tandat-EES-ICDM/EE3427_CC01_252_Group06_Embedded-System/README.md

[Demo Video]:  
https://drive.google.com/file/d/16Uh21a4lqSv_YghYvDpnQTZxxrZzBnIu/view?usp=drive_link  
[Demo Video - Revised: Add 2 more non-volatile alarms -> total 3 alarms]:  
https://drive.google.com/file/d/1G-kM-oG9oD7Pn4vBYBXZ9WEiFOjN3P8L/view?usp=sharing
