tandat-EES-ICDM/EE3427_CC01_252_Group06_Embedded-System/01_DESIGN/Requirements.xlsx

Sheet: Functional_Requirements
ID | Requirement
FR-1 | Time display mode
FR-1.1 | The system shall display time information on a 16×2 LCD in the “time display” screen. In time display mode, the screen shall update at least once per second.
FR-1.2 | The first LCD row shall show HH:MM:SS in 24-hour format (00–23).
FR-1.2.a | The first row shall show a bell icon when the alarm status is Activated (Mode 1) and show no bell when alarm status is Deactivated (Mode 0)
FR-1.2.b | The first row shall show a thermometer icon and show temperature value read from the DS3231 internal temperature sensor (integer, no fractional part) followed by “°C”.
FR-1.3 | The system shall display day-of-week and date on LCD row 2.
FR-1.3.a | Day-of-week shall be shown as a 3-letter abbreviation (Mon…Sun).
FR-1.3.b | Date format shall be DD/MM/YYYY.
FR-2 | Power-up screen
FR-2.1 | On power-up, the system shall show a splash screen: Row 1 “Real Time Clock”, Row 2 “With Alarm”, for 2 seconds, then clear and enter time display mode.
FR-3 | Set Time mode (7-step editing)
FR-3.1 | From time display mode, the system shall enter Set Time mode when SET TIME button is pressed and allow editing of 7 fields in sequence: hour → minute → second → day-of-week → date → month → year by pressing "SET TIME" button | Digtal Clock with LCD Display
FR-3.1.a | The currently edited field shall blink to indicate what is being edited.
FR-3.1.b | Hour shall wrap 23→00 and 00→23.
FR-3.1.c | Minute and second shall wrap 59→00 and 00→59.
FR-3.1.d | Day-of-week shall increment/decrement and wrap 7→0 and 0→7. |  | s
FR-3.1.e | Date shall wrap 31→0 and 0→31.
FR-3.1.f | Month shall wrap 12→0 and 0→12.
FR-3.1.g | Year shall increment and wrap 2030→2000; decrement and wrap below 0→2030.
FR-3.2 | When completing Set Time, the system shall write the new values to the RTC and display a finish message: Row 1 “Set Date Finish” and Row 2 “Set Time Finish”, then return to time display mode.
FR-4 | Early commit behavior for Set Time
FR-4.1 | While setting time, the system shall allow early commit without stepping through all 7 fields by pressing SET ALARM (commit immediately and show finish messages).
FR-5 | Set Alarm mode (5-step editing)
FR-5.1 | From time display mode, pressing SET ALARM button shall enter Set Alarm mode and allow editing in 5 steps : status (Activated or Deactivated) → hour → minute → second → save by pressing "SET ALARM" button.
FR-5.1.a | Step 1 shall blink the status field; UP selects “Activated ” and DOWN selects “Deactivate” (displayed as “Alarm Activated ” / “Alarm Deactivate”).
FR-5.1.b | Steps 2–4 adjust alarm hour/min/sec (00–23 / 00–59 / 00–59) with saturation at limits (no wrap).
FR-5.1.c | Step 5 shall display “Set Alarm Finish” and “-EEPROM Updated-”, then return to time display mode.
FR-6 | Early commit behavior for Set Alarm
FR-6.1 | While setting alarm, the system shall allow early commit without stepping through all 5 steps by pressing SET TIME (commit immediately and show finish messages “Set Alarm Finish” and “-EEPROM Updated-”).
FR-7 | Alarm persistence in EEPROM
FR-7.1 | The system shall store alarm hour/min/sec and activation status in MCU internal EEPROM and restore them at boot.
FR-7.1.a | EEPROM update shall occur at the end of Set Alarm (“-EEPROM Updated-”).
FR-7.1.b | Alarm settings shall persist across power loss.
FR-7.1.c | EEPROM writes shall occur only when saving alarm settings.
FR-8 | Alarm trigger and buzzer output
FR-8.1 | When alarm is activated, the system shall drive the buzzer when current time matches alarm time.
FR-8.1.a | The buzzer shall be driven by a 0/5 V digital output (active-high) on the buzzer pin.
FR-8.1.b | When triggered, the system shall generate an audible beep by driving buzzer HIGH for 300 ms then LOW
FR-9 | Button press and press-and-hold behavior
FR-9.1 | UP and DOWN buttons shall support both single-step increments and press-and-hold for faster adjustment (hold repeats while button remains pressed).

Sheet: NonFunctional_Requirements
ID | Requirement
NFR-1 | Firmware/Hardware implementation constraints
NFR-1.1 | Firmware shall be implemented in register-level C/C++ using AVR-GCC in Microchip Studio and shall not use Arduino core/libraries (Wire.h, LiquidCrystal.h, etc.).
NFR-1.1.a | All I2C and LCD access shall be implemented via direct AVR registers.
NFR-1.1.b | The firmware shall implement explicit state machines for Set Time (7 steps) and Set Alarm (5 steps).
NFR-1.1.c | Firmware shall avoid polling and use timer interrupts to reduce power.
NFR-1.1.d | Arduino code & Arduino core may be used only to verify functional behavior, not as part of the final firmware & hardware.
NFR-2 | Responsiveness
NFR-2.1 | Button response time (press to UI action) shall be < 50 ms.
NFR-2.1.a | Debounce Filter shall be ≤ 30 ms.
NFR-2.1.b | Hold detection shall start within 500 ms of continuous press.
NFR-3 | Time accuracy
NFR-3.1 | The displayed time shall have error < 1 s/day (driven by DS3231 accuracy).
NFR-3.1.a | System shall read time from RTC at least once per second. | Digtal Clock with LCD Display
NFR-3.1.b | MCU clock tolerance shall not affect timekeeping (RTC is time base).
NFR-3.1.c | Alarm trigger shall reference module RTC.
NFR-4 | Power source and operating rails
NFR-4.1 | The system shall operate from a 9V DC input supplied by either a 9V battery or a 9V adapter.
NFR-4.1.a | The acceptable input voltage range shall be 8–12 V DC.
NFR-4.1.b | The system shall generate a regulated 5V rail for ATmega168PA and peripherals (DS3231, 16×2 LCD, buzzer driver).
NFR-4.1.c | When powered by a 9V battery, the system shall operate continuously for ≥ X hours under typical load (X based on measured test).
NFR-4.1.d | Battery capacity shall be selected such that ≥ 30% margin remains after the required runtime.
NFR-5 | Power regulation choice
NFR-5.1 | The design shall specify whether a buck or linear regulator is used for converting 9V input to 5V and shall provide efficiency-based power calculations.
NFR-5.1.a | If powered by a 9V battery, a buck regulator shall be used unless justified otherwise.
NFR-5.1.b | If powered by a 9V adapter, a linear regulator may be used only if thermal dissipation is within safe limits; otherwise a buck regulator shall be used.
NFR-5.1.c | The 5V regulator shall support ≥ 200 mA peak load to cover buzzer + LCD/backlight transients.
NFR-5.1.d | LCD backlight current shall be limited to ≤ 20 mA continuous (fixed ON, no PWM).
NFR-6 | PCB/layout constraints (If possible)
NFR-6.1 | PCB shall follow layout constraints.
NFR-6.1.a | Power traces shall be ≥ 20–30 mil width.
NFR-6.1.b | Crystal and decoupling capacitors shall be placed close to MCU pins.
NFR-6.1.c | A copper ground plane shall be used for noise reduction.
NFR-6.1.d | Board outline shall not exceed 140 mm × 100 mm.
