tandat-EES-ICDM/EE3427_CC01_252_Group06_Embedded-System/05_BOM/BOM_v2.xlsx

Bill of Materials (BOM)
1. Main control unit
No. | Component | Model / Specification | Qty | Selection Rationale
1 | Microcontroller | STM32F103C8T6 | 1 | 64KB Flash I2C used for RTC module Enough pins for LCD, buttons, buzzer
2 | Crystal Oscillator | 8MHz | 1 | Stable clock source for precise timing and I2C
3 | Capacitor | 22pF Ceramic | 2 | Crystal load capacitors
4 | Resistor | 10kΩ 1/4W | 1 | RESET pull-up
5 | Capacitor | 100nF Ceramic | 5 | MCU decoupling (VCC/AVCC)
2. Real-time Clock (RTC) block
No. | Component | Model / Specification | Qty | Selection Rationale
6 | RTC Module | DS3231 (ZS-042 type) | 1 | <1s/day accuracy, integrated temperature sensor
7 | Backup Battery | CR2032 | 1 | Maintains time during power loss
8 | Resistor | 4.7kΩ | 2 | I2C pull-up resistors (if not included on module)
3. LCD Display block
No. | Component | Model / Specification | Qty | Selection Rationale
9 | LCD Module | LCD1602 / LM016L | 1 | HD44780 compatible, 5V operation, supports custom characters
10 | Trimpot | 10kΩ | 1 | LCD contrast adjustment
11 | Resistor | ~56Ω | 1 | Backlight current limiting (if not integrated)
12 | Transistor | S8050 / 2N2222 | 1 | Buzzer driver
13 | Resistor | 1kΩ | 1 | Base resistor for transistor
4. Alarm output block
No. | Component | Model / Specification | Qty | Selection Rationale
14 | Buzzer | Active 5V Buzzer | 1 | No need for tone generation (simplifies firmware)
15 | Transistor | 2N2222 / S8050 | 1 | Protects MCU from high current
16 | Resistor | 1kΩ | 1 | Base resistor for buzzer driver
5. User input block
No. | Component | Model / Specification | Qty | Selection Rationale
17 | Tactile Switch | 6x6mm Push Button | 4 | SET TIME, UP, DOWN, SET ALARM
18 | Resistor | 10kΩ | 4 | External pull-up
6. Power supply block
No. | Component | Model / Specification | Qty | Selection Rationale
18 | Buck Regulator IC | LM2596S-5 | 1 | ~85% efficiency, suitable for battery operation
19 | Schottky Diode | SS34 (3A, 40V) | 1 | Freewheel diode for buck converter
20 | Inductor | 33µH ≥1A | 1 | Buck converter energy storage
21 | Electrolytic Capacitor | 220µF 25V | 1 | Input bulk capacitor
22 | Electrolytic Capacitor | 220µF 10V | 1 | Output bulk capacitor
23 | Ceramic Capacitor | 100nF | 2–3 | Regulator bypass capacitors
24 | Polyfuse (optional) | 500mA–1A | 1 | Overcurrent protection
25 | 9V Battery | 9V Input | 1 | External power connector
26 | LDO Regulator IC | AMS1117-3.3 | 1 | Converts 5V rail to 3.3V
7. Programming & Connectivity
No. | Component | Model / Specification | Qty | Selection Rationale
27 | STLink connector | STLink V2 | 1 | Load firmware
28 | LCD Header | 1x16 2.54mm | 1 | LCD connection
29 | RTC Header | 1x4 2.54mm | 1 | DS3231 connection
Summary by Category
 | Category | Description
 | Core ICs | MCU + RTC + Buck Regulator
 | Discrete Components | Resistors, capacitors, transistors
 | Modules | LCD1602, DS3231
 | User Interface | 4 push buttons
 | Protection | Schottky diode + optional polyfuse
Design Justification
 | Sufficient GPIO and memory resources
 | Sufficient Flask memory for alarm storage
 | DS3231 ensures <1s/day accuracy
 | Buck regulator satisfies 24-hour battery requirement
 | Not over-dimensioned (avoids unnecessary cost)
 | Easily available in Vietnam
 | Compatible with PCB size constraint (<14cm × 10cm)
