tandat-EES-ICDM/EE3427_CC01_252_Group06_Embedded-System/02_Schematic_pdf/Digital Clock with LCD Display.pdf

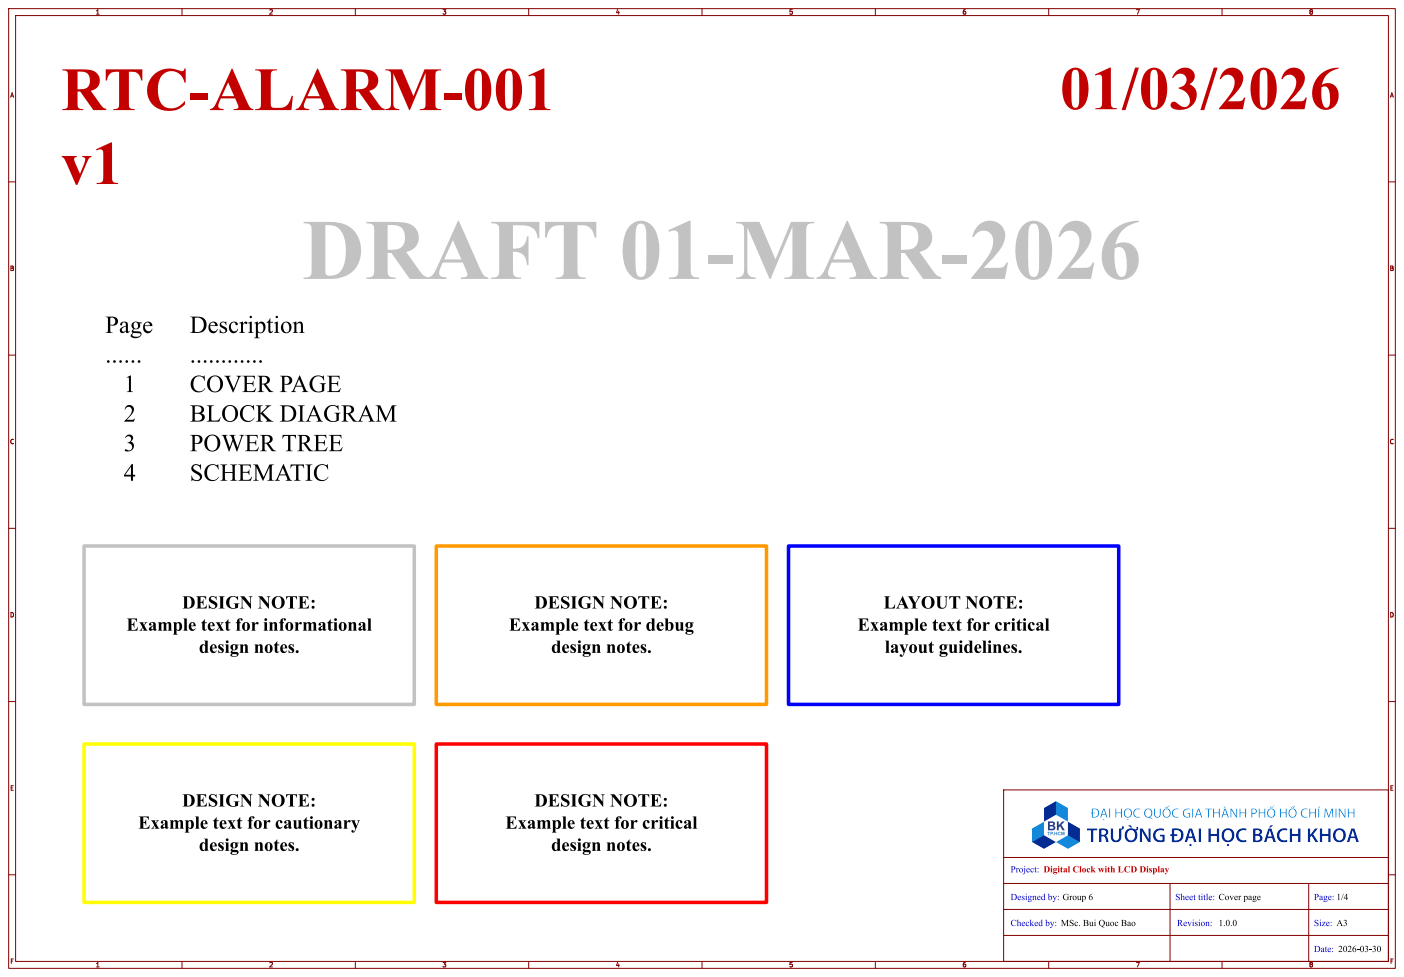
[picture p25: page 1]

File: untitled.kicad_sch main_schematic File: main_schematic.kicad_sch LAYOUT NOTE:

Designedby: Group6 | Sheettitle: Coverpage | Page:1/4 | F Project:

Checkedby: MSc.Bui QuocBao | Revision: 1.0.0 | Size: A3

Date: 2026-03-30

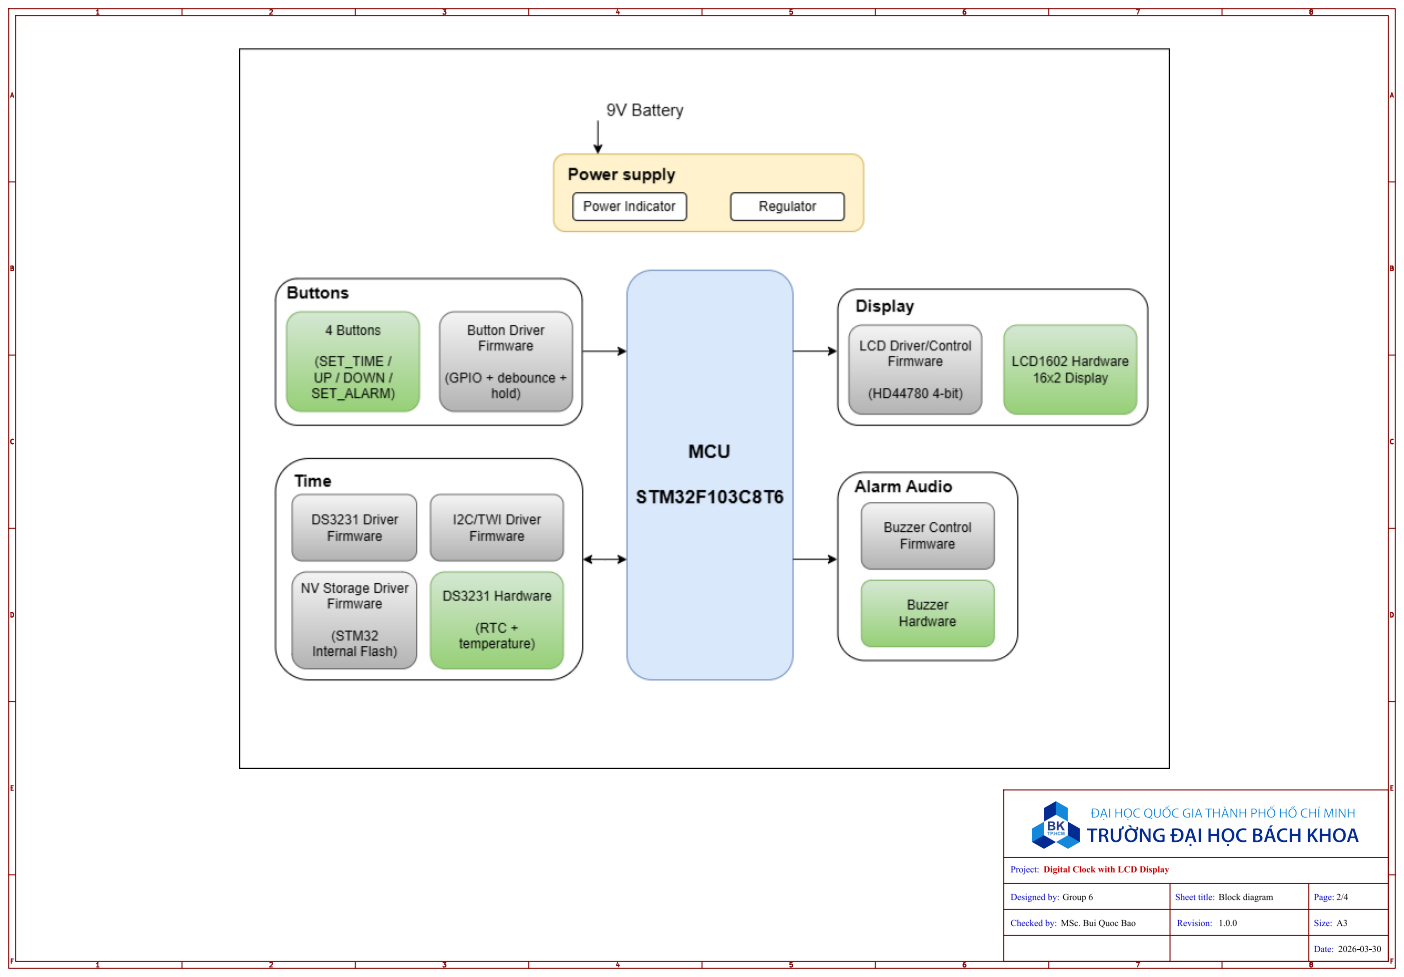
[picture p26: page 2]

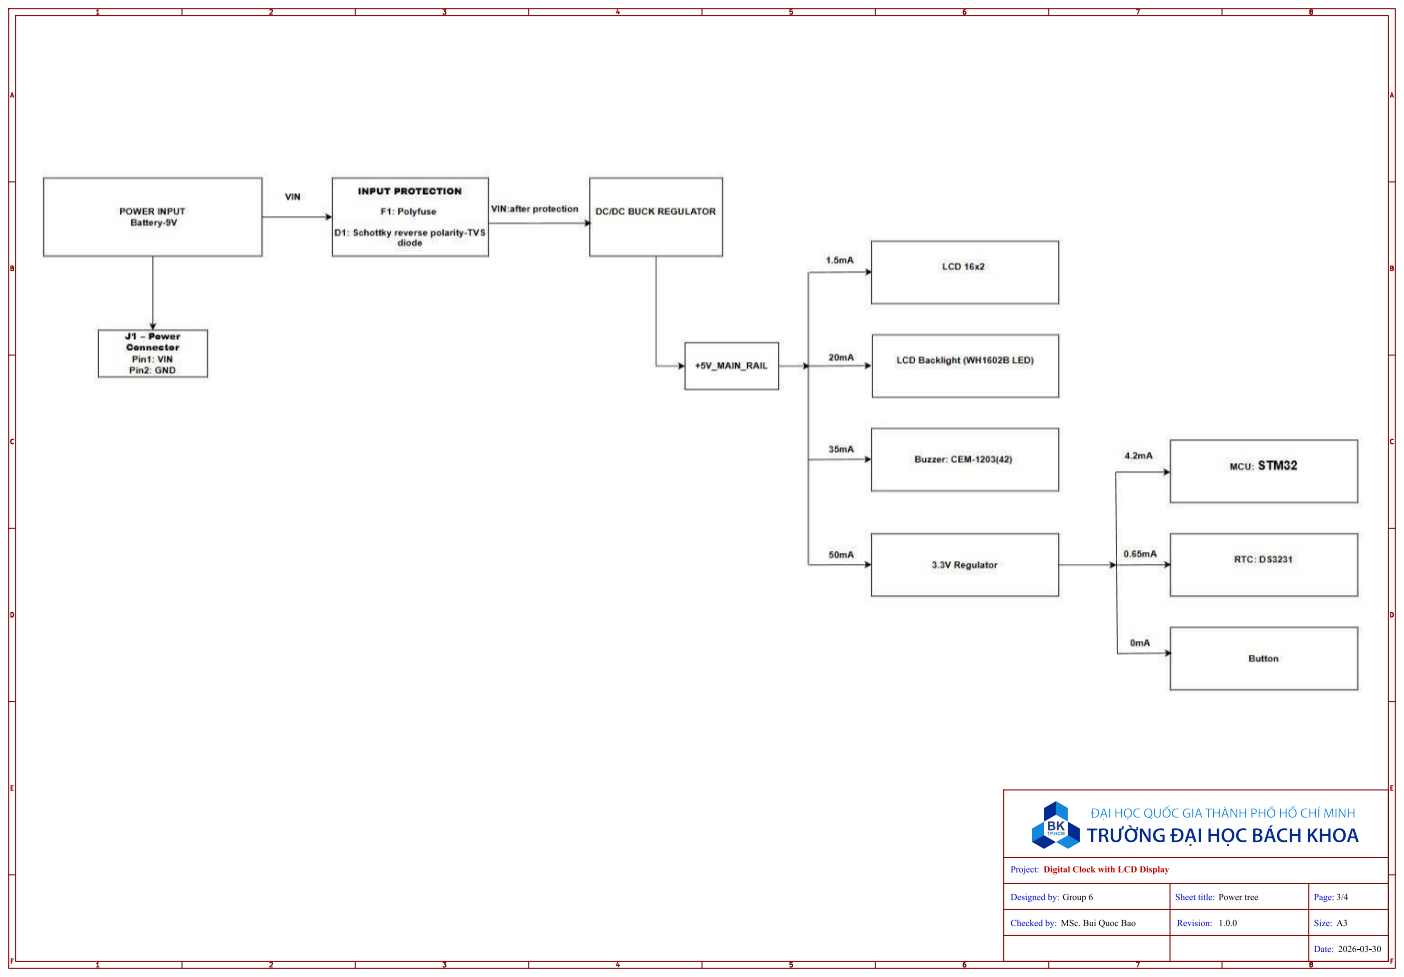
[picture p27: page 3]

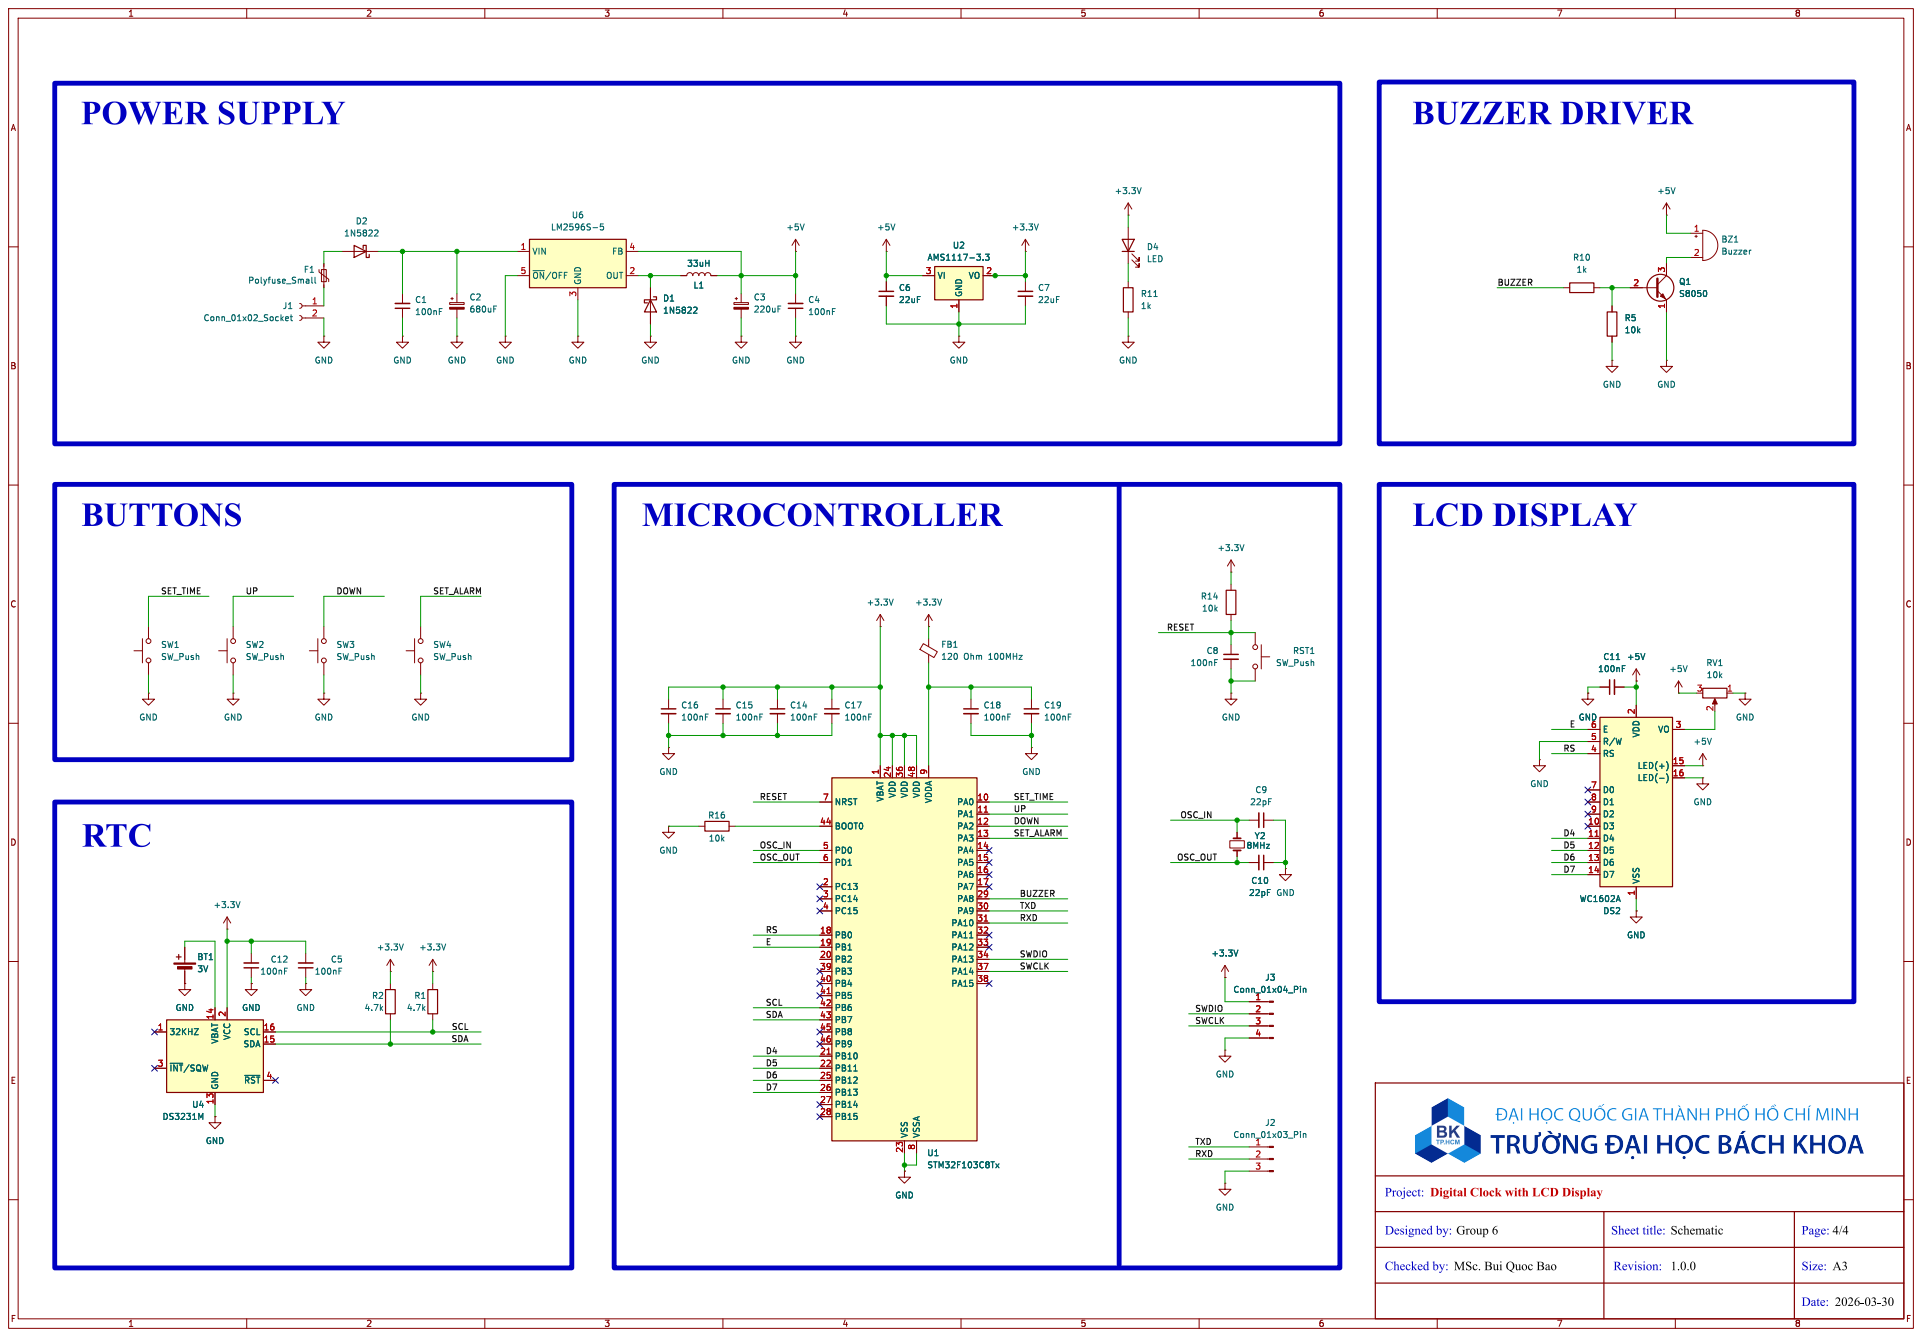
[picture p28: page 4]

1 VDD 24 VDD 36 VSS 23 VDD 48 VSSA

2 VBAT 14 GND 13
SCL 16 SDA 15 ~{RST}4 VCC
