tandat-EES-ICDM/EE3427_CC01_252_Group06_Embedded-System/04_GERBERS/RTC_Alarm_project_v2.kicad_pcb

## KiCad design 04_GERBERS/RTC_Alarm_project_v2.kicad_pcb (2026-04-13, last stored version)

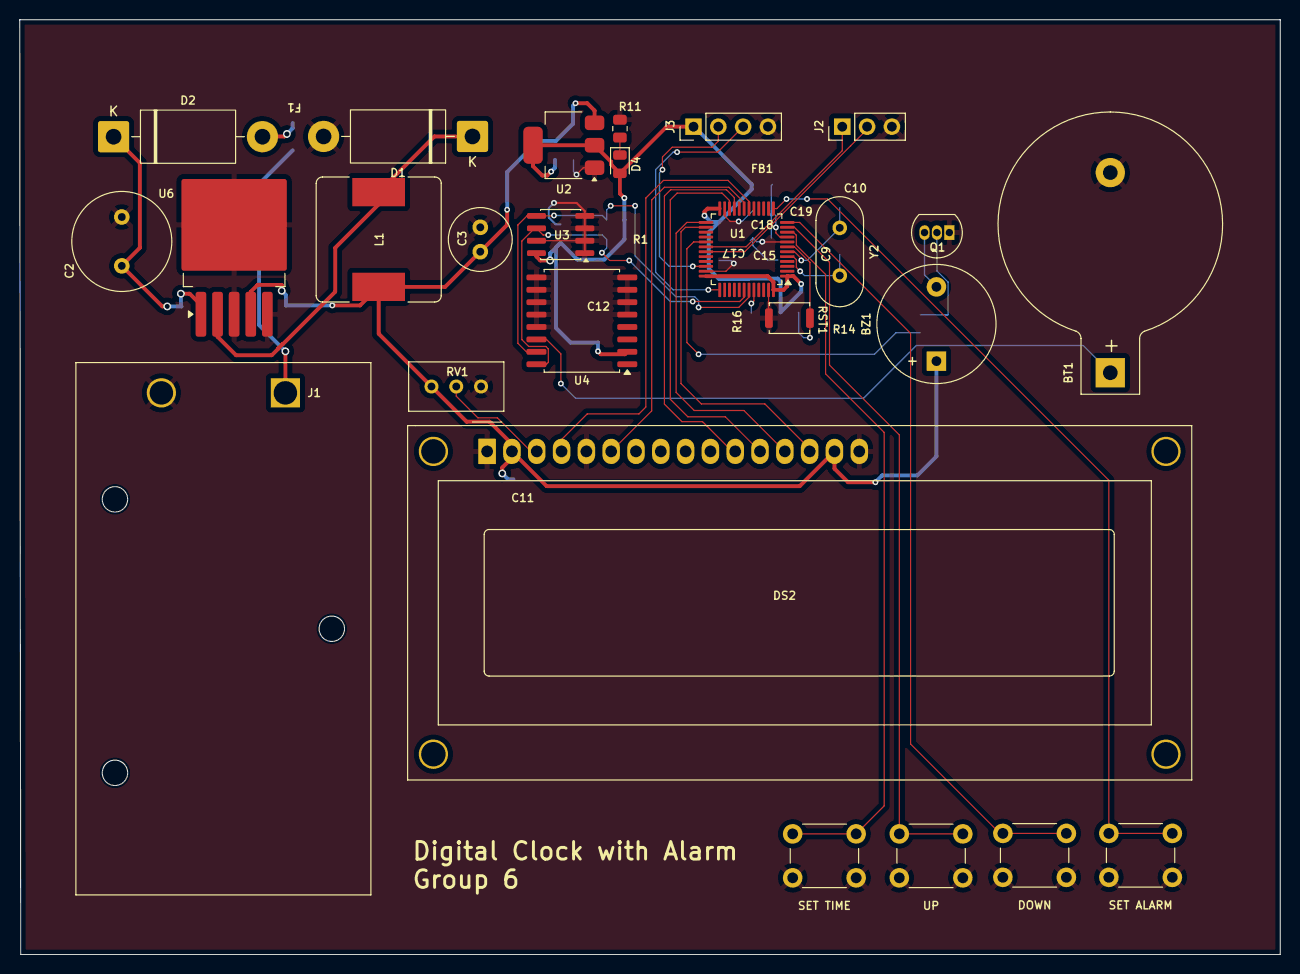
[picture p29: board RTC_Alarm_project_v2.kicad_pcb from above]

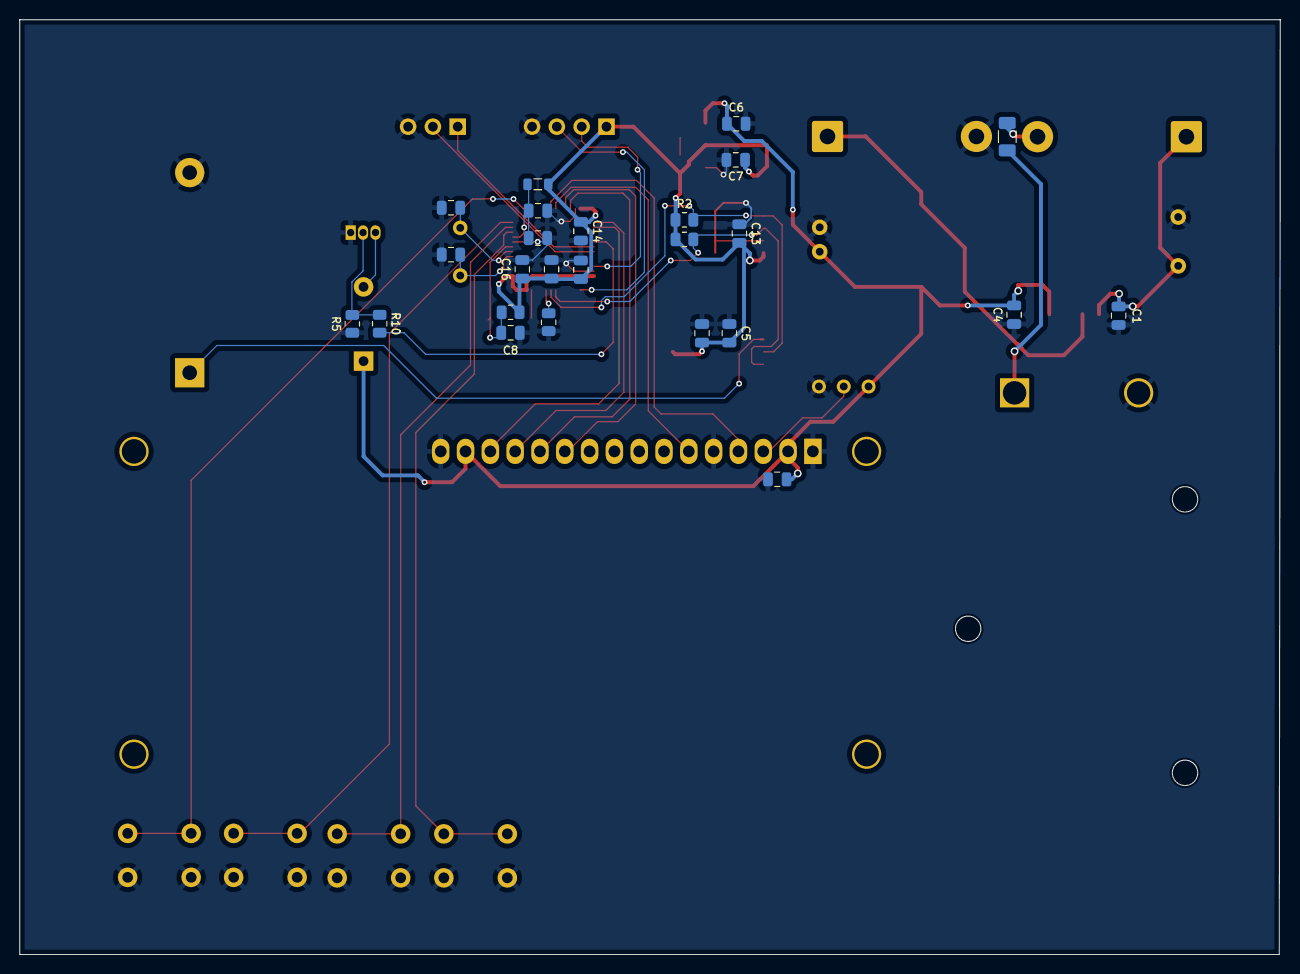
[picture p30: board RTC_Alarm_project_v2.kicad_pcb from below]

Board: 4 copper layers, 129.1 x 95.7 mm, 51 parts (25 on the bottom side), 34 nets.

Parts:
BT1: Battery_Cell; BatteryHolder_Keystone_103_1x20mm
BZ1: Buzzer; Buzzer_12x9.5RM7.6
C1, C4, C5, C8, C11, C12, C13, C14, C15, C16, C17, C18, C19: 100nF; C_0805_2012Metric
C2: 680uF; C_Radial_D10.0mm_H16.0mm_P5.00mm
C3: 220uF; C_Radial_D6.3mm_H7.0mm_P2.50mm
C6, C7: 22uF; C_0805_2012Metric
C9, C10: 22pF; C_0805_2012Metric
D1, D2: 1N5822; D_DO-201AD_P15.24mm_Horizontal
D4: LED; LED_0805_2012Metric
DOWN: SW_Push; SW_PUSH_6mm
DS2: WC1602A
F1: Polyfuse_Small; Fuse_1206_3216Metric
FB1: 120 Ohm 100MHz; L_0805_2012Metric
J1: Conn_01x02_Socket; BatteryHolder_Eagle_12BH611-GR
J2: Conn_01x03_Pin; PinHeader_1x03_P2.54mm_Vertical
J3: Conn_01x04_Pin; PinHeader_1x04_P2.54mm_Vertical
L1: 33uH; L_Bourns_SRR1260
Q1: S8050; TO-92_Inline
R1, R2: 4.7k; R_0805_2012Metric
R5, R14, R16: 10k; R_0805_2012Metric
R10, R11: 1k; R_0805_2012Metric
RST1: SW_Push; SW_Push_SPST_NO_Alps_SKRK
RV1: 10k; Potentiometer_Bourns_3296W_Vertical
SET ALARM: SW_Push; SW_PUSH_6mm
SET TIME: SW_Push; SW_PUSH_6mm
U1: STM32F103C8Tx; LQFP-48_7x7mm_P0.5mm
U2: AMS1117-3.3; SOT-223-3_TabPin2
U3: AT24CS32-SSHM; SOIC-8_3.9x4.9mm_P1.27mm
U4: DS3231M; SOIC-16W_7.5x10.3mm_P1.27mm
U6: LM2596S-5; TO-263-5_TabPin3
UP: SW_Push; SW_PUSH_6mm
Y2: 8MHz; Crystal_HC49-4H_Vertical

Connections:
+3.3V: C5.2, C7.1, C12.2, C13.2, C14.1, C15.1, C16.1, C17.1, D4.2 (A), FB1.1, J3.1, R1.1, R2.1, R14.1, U1.1 (VBAT), U1.24 (VDD), U1.36 (VDD), U1.48 (VDD), U2.2 (VO), U3.8 (VCC), U4.2 (VCC)
+5V: BZ1.1 (+), C3.1, C4.2, C6.1, C11.2, DS2.2 (VDD), DS2.15 (LED(+)), L1.2, RV1.3, U2.3 (VI), U6.4 (FB)
/main_schematic/BUZZER: R10.2, U1.29 (PA8)
/main_schematic/D4: DS2.11 (D4), U1.21 (PB10)
/main_schematic/D5: DS2.12 (D5), U1.22 (PB11)
/main_schematic/D6: DS2.13 (D6), U1.25 (PB12)
/main_schematic/D7: DS2.14 (D7), U1.26 (PB13)
/main_schematic/DOWN: DOWN.2, U1.12 (PA2)
/main_schematic/E: DS2.6 (E), U1.19 (PB1)
/main_schematic/OSC_IN: C9.2, U1.5 (PD0), Y2.2
/main_schematic/OSC_OUT: C10.2, U1.6 (PD1), Y2.1
/main_schematic/RESET: C8.1, R14.2, RST1.2, U1.7 (NRST)
/main_schematic/RS: DS2.4 (RS), U1.18 (PB0)
/main_schematic/RXD: J2.2, U1.31 (PA10)
/main_schematic/SCL: R1.2, U1.42 (PB6), U3.6 (SCL), U4.16 (SCL)
/main_schematic/SDA: R2.2, U1.43 (PB7), U3.5 (SDA), U4.15 (SDA)
/main_schematic/SET_ALARM: SET ALARM.2, U1.13 (PA3)
/main_schematic/SET_TIME: SET TIME.2, U1.10 (PA0)
/main_schematic/SWCLK: J3.3, U1.37 (PA14)
/main_schematic/SWDIO: J3.2, U1.34 (PA13)
/main_schematic/TXD: J2.1, U1.30 (PA9)
/main_schematic/UP: U1.11 (PA1), UP.2
GND: BT1.2 (-), C1.1, C2.2, C3.2, C4.1, C5.1, C6.2, C7.2, C8.2, C9.1, C10.1, C11.1, C12.1, C13.1, C14.2, C15.2, C16.2, C17.2, C18.2, C19.2, D1.2 (A), DOWN.1, DS2.1 (VSS), DS2.5 (R/W), DS2.16 (LED(-)), J1.2, J2.3, J3.4, Q1.1 (E), R5.1, R11.2, R16.1, RST1.1, RV1.1, SET ALARM.1, SET TIME.1, U1.8 (VSSA), U1.23 (VSS), U1.35 (VSS), U1.47 (VSS), U2.1 (GND), U3.1 (A0), U3.2 (A1), U3.3 (A2), U3.4 (GND), U3.7 (WP), U4.5 (GND), U4.6 (GND), U4.7 (GND), U4.8 (GND), U4.9 (GND), U4.10 (GND), U4.11 (GND), U4.12 (GND), U4.13 (GND), U6.3 (GND), U6.5 (~ON/OFF), UP.1
unnamed: BT1.1 (+), U4.14 (VBAT)
unnamed: BZ1.2 (-), Q1.3 (C)
unnamed: D1.1 (K), L1.1, U6.2 (OUT)
unnamed: D2.2 (A), F1.1
unnamed: C1.2, C2.1, D2.1 (K), U6.1 (VIN)
unnamed: D4.1 (K), R11.1
unnamed: DS2.3 (VO), RV1.2
unnamed: F1.2, J1.1
unnamed: Q1.2 (B), R5.2, R10.1
unnamed: R16.2, U1.44 (BOOT0)
unnamed: C18.1, C19.1, FB1.2, U1.9 (VDDA)
