tandat-EES-ICDM/EE3427_CC01_252_Group06_Embedded-System/(commit log)

2026-01-25 Non Functional Requirement by tdat
    [NF_Requirements_Specifications.xlsx]
2026-03-09 Rename Bill of Materials.xlsx to 03_BOM/Bill of Materials.xlsx
    [Bill of Materials.xlsx]
2026-03-09 Rename Schematic (Kicad).pdf to 02_Schematic_pdf/Schematic (Kicad).pdf
2026-03-09 Upload Requirement Ver2
    [Requirements.xlsx]
